Doantheodoisuckhoe/Thietbitheodoisuckhoe/docs/giao-thuc-ble.md

# Giao thức BLE giữa đồng hồ và app

Tài liệu cho người làm app (SV2). Firmware tương ứng: `firmware/ble_suc_khoe/ble_suc_khoe.ino`.

## Cách hệ thống gửi cảnh báo (phương án 1, chốt 21/10/2026)

```
Đồng hồ (XIAO nRF52840) --BLE--> App Android trên điện thoại người già --SMS / gọi--> Người thân
                                          \--(sau M2) Firebase --> Web cho người thân xem
```

Đồng hồ chỉ có Bluetooth, không có SIM. App là thứ gửi SMS, nên:
- App phải chạy nền liên tục (Android: *foreground service* có thông báo cố định) và tự kết nối lại khi mất kết nối.
- Điện thoại phải ở trong khoảng ~10 m. Ngoài tầm thì cảnh báo nằm chờ trên đồng hồ, kết nối lại là được gửi
  (đồng hồ gửi lại mỗi 5 giây đến khi app xác nhận). Ghi giới hạn này vào báo cáo.

## Tìm và kết nối

- Tên quảng bá: `DoAn-SucKhoe`.
- Gói quảng bá chứa UUID service riêng `4b3a0001-8f6e-4c2a-9d1b-3e5f7a9c0b1d`: lọc khi quét theo UUID này.
- Không cần ghép đôi (pairing), không có mã PIN.

## Các service và đặc tính

| Service | Đặc tính | UUID | Thuộc tính | Nội dung |
|---|---|---|---|---|
| Riêng `4b3a0001-…` | **Số đo** | `4b3a0002-8f6e-4c2a-9d1b-3e5f7a9c0b1d` | Read, Notify | 10 byte, mỗi giây 1 lần |
| | **Cảnh báo** | `4b3a0003-8f6e-4c2a-9d1b-3e5f7a9c0b1d` | Read, Notify | 4 byte, khi có cảnh báo (gửi lại mỗi 5 giây đến khi xác nhận) |
| | **Lệnh** | `4b3a0004-8f6e-4c2a-9d1b-3e5f7a9c0b1d` | Write, Write without response | 1–5 byte, app gửi xuống |
| | **ECG** | `4b3a0005-8f6e-4c2a-9d1b-3e5f7a9c0b1d` | Notify | gói sóng điện tim khi đang đo 30 giây (từ 28/10/2026) |
| Heart Rate chuẩn `0x180D` | Heart Rate Measurement `0x2A37` | | Notify | nhịp tim, để thử bằng nRF Connect |
| Battery chuẩn `0x180F` | Battery Level `0x2A19` | | Read, Notify | % pin |
| Device Information `0x180A` | | | Read | tên hãng, model |

Mọi số nhiều byte đều **little endian** (byte thấp trước).

### Số đo (10 byte)

| Byte | Kiểu | Tên | Ý nghĩa |
|---|---|---|---|
| 0 | uint8 | phiên bản | luôn `1`; đổi định dạng thì tăng số này |
| 1 | uint8 | cờ | bit0 = đang đeo (cảm biến chạm da), bit1 = nhiệt độ hợp lệ, bit2 = SpO2 hợp lệ, bit3 = IMU hoạt động, bit4 = pin yếu (< 3,5 V, từ 12/11/2026) |
| 2 | uint8 | nhịp tim | lần/phút, `0` = chưa có |
| 3 | uint8 | SpO2 | %, `0` = chưa có |
| 4–5 | int16 | nhiệt độ | đơn vị 0,01 °C (`3650` = 36,50 °C) |
| 6–7 | uint16 | pin | mV |
| 8 | uint8 | pin | % (ước lượng 3,3 V = 0 %, 4,2 V = 100 %) |
| 9 | uint8 | cảnh báo đang chờ | số thứ tự cảnh báo chưa được app xác nhận, `0` = không có |

Ví dụ: `01 07 48 61 42 0E 68 10 50 00` → đang đeo, nhiệt độ + SpO2 hợp lệ, nhịp 72, SpO2 97 %,
nhiệt độ 0x0E42 = 3650 → 36,50 °C, pin 0x1068 = 4200 mV, 80 %, không có cảnh báo chờ.

**Lưu ý:** SpO2 đang dùng công thức chung, chưa hiệu chuẩn; nhiệt độ là nhiệt độ da cổ tay (thấp hơn thân nhiệt).
Cả hai sẽ được chỉnh khi đo đối chứng với máy kẹp ngón và nhiệt kế.

### Cảnh báo (4 byte)

| Byte | Kiểu | Tên | Ý nghĩa |
|---|---|---|---|
| 0 | uint8 | mã | xem bảng dưới; `0` = không có cảnh báo |
| 1 | uint8 | số thứ tự | 1–255, tăng mỗi cảnh báo mới. App dùng để không gửi SMS 2 lần cho cùng một cảnh báo |
| 2–3 | uint16 | giá trị | nhịp tim, SpO2 hoặc nhiệt độ (0,01 °C) lúc báo; `0` với SOS và té ngã |

| Mã | Tên | Khi nào đồng hồ báo | Mức |
|---|---|---|---|
| 1 | SOS | Giữ nút SOS 1 giây | Khẩn cấp |
| 2 | Té ngã | IMU phát hiện té ngã, rung 15 giây mà người đeo không bấm nút hủy | Khẩn cấp |
| 3 | Nhịp tim cao | > 120 lần/phút liên tục 15 giây | Chỉ số |
| 4 | Nhịp tim thấp | < 40 lần/phút liên tục 15 giây | Chỉ số |
| 5 | SpO2 thấp | < 90 % liên tục 15 giây | Chỉ số |
| 6 | Sốt | ≥ 38,0 °C liên tục 15 giây | Chỉ số |

Cảnh báo chỉ số cùng loại không báo lại trong 5 phút. Đồng hồ giữ **một** cảnh báo chờ tại một thời điểm;
SOS/té ngã được ghi đè lên cảnh báo chỉ số đang chờ, ngược lại thì không.

### Lệnh (app ghi xuống)

| Byte | Ý nghĩa |
|---|---|
| `01 nn` | Xác nhận đã xử lý cảnh báo số thứ tự `nn` (đã gửi SMS). Đồng hồ ngừng gửi lại và rung dài 1 giây để người đeo biết "đã báo người thân" |
| `02` | Tìm đồng hồ: rung 2 giây |
| `03` | Bắt đầu đo ECG 30 giây (chỉ chạy khi app đã bật notify ở đặc tính ECG) |
| `04` | Dừng đo ECG giữa chừng |
| `05 t0 t1 t2 t3` | Đặt giờ: số giây từ 01/01/2000 00:00 **theo giờ địa phương** (uint32 little-endian). App gửi mỗi lần kết nối. Đồng hồ không có pin RTC riêng: mất nguồn thì hiện `--:--` cho tới lần kết nối sau |

| `06 ss` | Thời gian màn hình sáng khi bấm nhanh nút: `ss` giây (3–120, ngoài khoảng thì đồng hồ ép về 3 hoặc 120). Mặc định 10. App gửi mỗi lần kết nối và khi đổi trong app (từ 12/11/2026) |
| `07 AA` | Tắt hẳn đồng hồ (System OFF). Byte `AA` để tránh tắt nhầm. Bật lại: giữ nút 2 giây hoặc cắm sạc (từ 12/11/2026) |

Ví dụ đặt giờ 30/10/2026 12:34:56: 846 678 896 giây = 0x32774B70 → ghi `05 70 4B 77 32`.

### Tiết kiệm pin và tắt hẳn (từ 12/11/2026)

Đồng hồ **không tắt khi không dùng**, vì lúc người đeo không đụng vào đồng hồ vẫn cần canh té ngã và nhịp tim.
Thay vào đó:

- Màn hình tắt khi không dùng; bấm nhanh nút thì sáng trong thời gian cài bằng lệnh `06`.
  Té ngã, cảnh báo đang chờ, "đã báo người thân" thì màn tự sáng.
- CPU ngủ giữa các lần đọc cảm biến (mỗi 10 ms), trừ lúc đang đo ECG.
- Pin < 3,5 V (2 lần đọc liên tiếp, cách nhau 30 giây): rung 3 lần, bật bit4 "pin yếu" trong gói Số đo.
- Pin < 3,4 V (2 lần liên tiếp), không cắm USB: rung 2 lần dài rồi **tắt hẳn** để không xả cạn pin.
  Không tắt khi đang đếm hủy té ngã, đang đo ECG, hoặc có cảnh báo chờ mà điện thoại đang kết nối.
- Đang tắt hẳn: giữ nút 2 giây thì bật (rung ngắn 1 lần). Bấm nhanh thì ngủ lại. Cắm sạc cũng làm đồng hồ bật.

Giới hạn: mạch không có khóa nguồn, nên khi "tắt hẳn" AD8232 (~0,2 mA) vẫn ăn pin; màn GC9A01 **7 chân**
không có chân BLK nên đèn nền sáng suốt (10–20 mA) kể cả khi tắt. Dùng màn 8 chân, nối BLK → D3.

### ECG (gói sóng điện tim)

Khi nhận lệnh `03`, đồng hồ đọc OUTPUT của AD8232 (chân A0, ADC 12 bit) **250 mẫu/giây trong 30 giây**
(7500 mẫu) bằng ngắt TIMER4, rồi gửi dần qua notify. Chân D1 (LO+/LO- gộp) = 1 nghĩa là tuột điện cực.

| Byte | Kiểu | Tên | Ý nghĩa |
|---|---|---|---|
| 0–1 | uint16 | số gói | 0, 1, 2… trong một lần đo. App thấy nhảy số thì biết mất gói |
| 2 | uint8 | cờ | bit0 = có mẫu bị tuột điện cực trong gói, bit1 = gói cuối của lần đo |
| 3 | uint8 | n | số mẫu trong gói |
| 4… | n × uint16 | mẫu | giá trị ADC 0–4095 |

- App xin MTU 247 ngay khi kết nối. MTU ≥ 57 thì mỗi gói 25 mẫu (54 byte, 10 gói/giây); nếu không xin được thì
  8 mẫu/gói (20 byte, vừa MTU mặc định 23).
- Gói cuối có cờ bit1; có thể là gói rỗng (`n = 0`).
- Đồng hồ có bộ đệm 512 mẫu (~2 giây). Bluetooth gửi không kịp thì mẫu mới bị bỏ, lần đo vẫn dài đúng 30 giây,
  app thấy thiếu mẫu. Mất kết nối hoặc quá 45 giây chưa gửi xong thì đồng hồ tự dừng.
- Trong lúc đo đồng hồ vẫn gửi Số đo mỗi giây và cảnh báo như bình thường (bỏ qua đọc pin).

Ví dụ: `0C 00 01 02 D0 07 DA 07` → gói số 12, có tuột điện cực, 2 mẫu: 0x07D0 = 2000, 0x07DA = 2010.

App tính nhịp tim từ sóng (`app/suc_khoe/lib/ecg.dart`, bản Python `algorithm/ecg/phan_tich_ecg.py`):
lọc trung bình 5 mẫu (bỏ nhiễu 50 Hz), trừ trung bình 0,6 giây (bỏ trôi nền), rồi Pan-Tompkins rút gọn
(đạo hàm, bình phương, tích phân 150 ms, ngưỡng 0,3 × phân vị 98 %) để tìm đỉnh R; nhịp = 60 / trung vị R-R.

## Việc app cần làm khi nhận cảnh báo

1. Nếu `số thứ tự` trùng cảnh báo vừa xử lý → bỏ qua (đây là gói gửi lại).
2. Lấy vị trí GPS hiện tại của điện thoại.
3. Gửi SMS cho từng số người thân đã lưu trong app (Android `SmsManager`), ví dụ:
   `[DoAn-SucKhoe] CANH BAO TE NGA luc 14:32 21/10. Vi tri: https://maps.google.com/?q=21.0285,105.8542`
   Viết không dấu để 1 tin SMS chứa được 160 ký tự (có dấu chỉ còn 70).
4. Với SOS/té ngã: gọi điện cho người thân đầu tiên (tùy chọn).
5. Ghi `01 nn` vào đặc tính Lệnh.
6. (Sau M2) đẩy cảnh báo và số đo lên Firebase.

Quyền Android cần: `BLUETOOTH_SCAN`, `BLUETOOTH_CONNECT`, `SEND_SMS`, `CALL_PHONE`, `ACCESS_FINE_LOCATION`,
`FOREGROUND_SERVICE`, `POST_NOTIFICATIONS`. App có quyền gửi SMS không đưa được lên Google Play nếu không phải
app SMS mặc định, nhưng cài file APK trực tiếp để demo thì không sao.

## Thử khi chưa có app

- **Điện thoại:** app nRF Connect → SCAN → CONNECT `DoAn-SucKhoe` → mở service `4b3a0001-…` → bấm biểu tượng
  3 mũi tên ở Số đo và Cảnh báo để bật notify. Giữ nút SOS (hoặc chạm dây D9 vào GND) 1 giây để thấy cảnh báo.
  Ghi `0101` (kiểu byte array) vào Lệnh để xác nhận cảnh báo số 1.
  Thử ECG: bật notify ở đặc tính ECG rồi ghi `03` vào Lệnh, sẽ thấy gói ECG chạy liên tục trong 30 giây.
- **Máy tính có Bluetooth:** `pip install bleak`, rồi `python app/thu_ble_tren_may_tinh.py`. Script in số đo,
  in cảnh báo và tự gửi xác nhận, giống việc app sẽ làm (chỉ thiếu bước gửi SMS).
