Doantheodoisuckhoe/Thietbitheodoisuckhoe/docs/nhat-ky.md

# Nhật ký thực hiện

Ghi lại việc đã làm và quyết định quan trọng theo ngày — dùng lại khi viết báo cáo và trả lời hội đồng.
Mục mới nhất ở trên cùng.

## 05/10/2026 – Tuần 1: thiết lập dự án

**Đã làm**
- Tạo repo GitHub, clone về `C:\DoAnTotNghiep` (máy SV1); thêm `.gitattributes` chuẩn hóa xuống dòng.
- Tạo thư mục Drive chung với 6 mục: 01 Tài liệu tham khảo · 02 Dữ liệu đo · 03 Báo cáo và slide ·
  04 Hình ảnh, video · 05 Mạch và vỏ (bản phát hành) · 06 Hành chính.
- Bảng Trello theo dõi việc; báo cáo tiến độ tự động đăng tối Chủ Nhật trước giờ họp nhóm 20:30.
- Cài Arduino IDE 2.3.10, gói Seeed nRF52 Boards 1.1.13 và 6 thư viện cảm biến; sketch
  `firmware/kiem_tra_thu_vien` biên dịch được cho XIAO nRF52840 Sense.
- Chốt danh sách mua đợt 1 (~2,03 triệu): xem `docs/mua-sam/`.

**Quyết định**
- Dùng gói board *Seeed nRF52 Boards* (không dùng bản mbed): có Bluefruit cho BLE, tiết kiệm pin tốt hơn.
- Máy đo đối chứng: máy SpO2 Jumper JPD-500E, nhiệt kế Omron MC-246, dùng máy huyết áp bắp tay nhóm đã có.
- Vẽ vỏ bằng **Onshape** (gói Education, miễn phí với email sinh viên): chạy trên trình duyệt, không cài,
  cả nhóm cùng mở, xuất STL để in 3D.

**Trạng thái**
- Đề cương: đã nộp, chờ GVHD duyệt.
- Chưa biết ngày nộp báo cáo, ngày bảo vệ và quy định trình bày — cần hỏi GVHD trước 11/10.
- Chưa có linh kiện.
