Doantheodoisuckhoe/Thietbitheodoisuckhoe/firmware/ble_suc_khoe/xem_truoc/anh/1_man_chinh.png

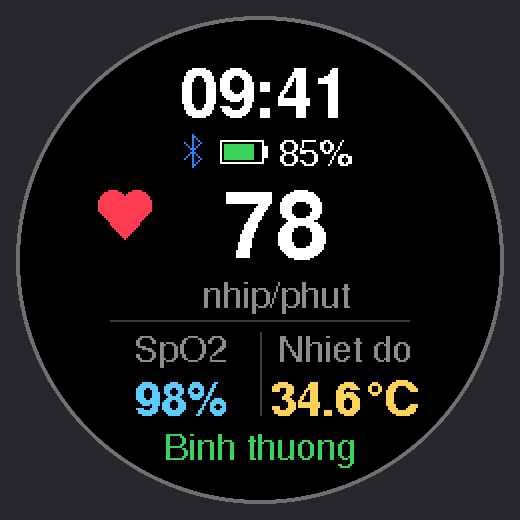
firmware/ble_suc_khoe/xem_truoc/anh/1_man_chinh.png
