Doantheodoisuckhoe/Thietbitheodoisuckhoe/firmware/ble_suc_khoe/xem_truoc/anh/2_man_chinh_mat_ket_noi.png

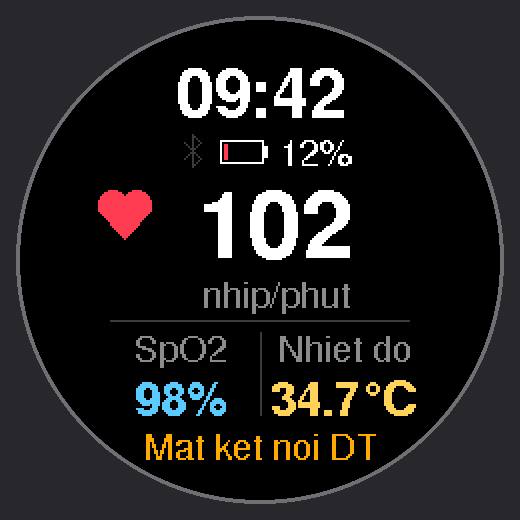
firmware/ble_suc_khoe/xem_truoc/anh/2_man_chinh_mat_ket_noi.png
