Doantheodoisuckhoe/Thietbitheodoisuckhoe/firmware/ble_suc_khoe/xem_truoc/anh/3_chua_deo.png

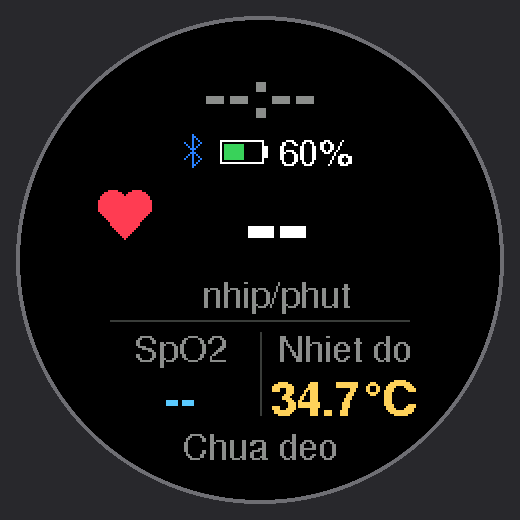
firmware/ble_suc_khoe/xem_truoc/anh/3_chua_deo.png
