Doantheodoisuckhoe/Thietbitheodoisuckhoe/firmware/ble_suc_khoe/xem_truoc/anh/4_te_nga_dem_nguoc.png

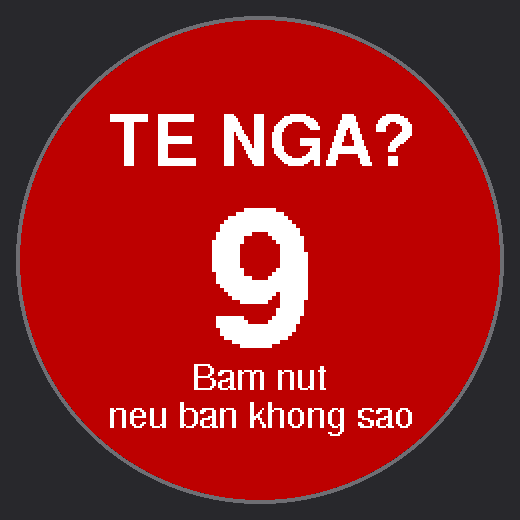
firmware/ble_suc_khoe/xem_truoc/anh/4_te_nga_dem_nguoc.png
