Doantheodoisuckhoe/Thietbitheodoisuckhoe/firmware/ble_suc_khoe/xem_truoc/anh/5_sos.png

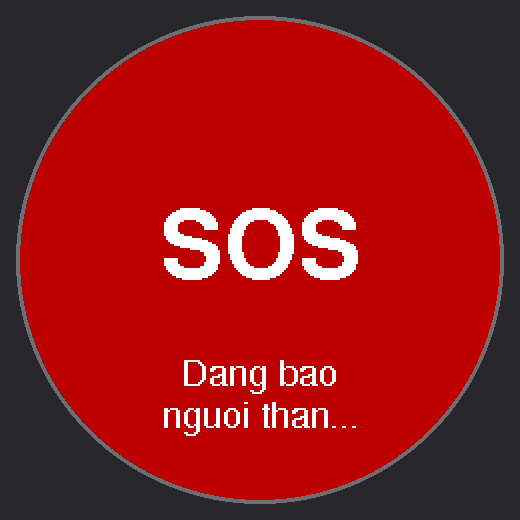
firmware/ble_suc_khoe/xem_truoc/anh/5_sos.png
