Doantheodoisuckhoe/Thietbitheodoisuckhoe/firmware/ble_suc_khoe/xem_truoc/anh/6_nhip_tim_cao.png

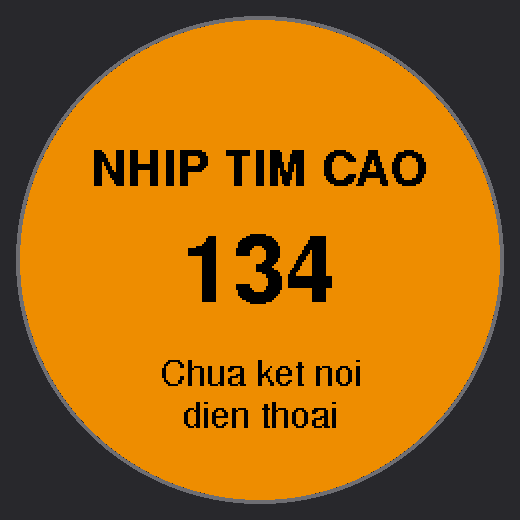
firmware/ble_suc_khoe/xem_truoc/anh/6_nhip_tim_cao.png
