Doantheodoisuckhoe/Thietbitheodoisuckhoe/firmware/ble_suc_khoe/xem_truoc/anh/7_sot.png

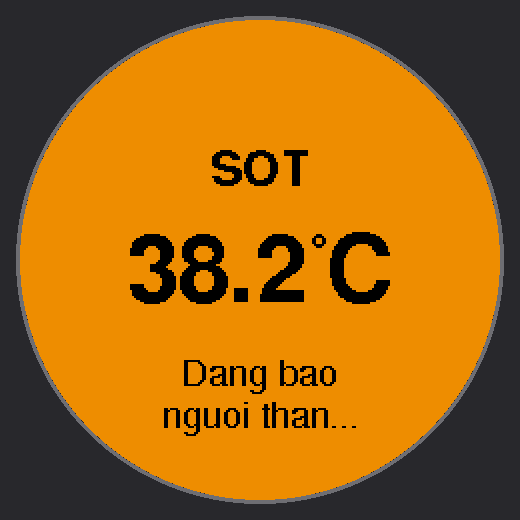
firmware/ble_suc_khoe/xem_truoc/anh/7_sot.png
