Doantheodoisuckhoe/Thietbitheodoisuckhoe/firmware/ble_suc_khoe/xem_truoc/anh/8_da_bao.png

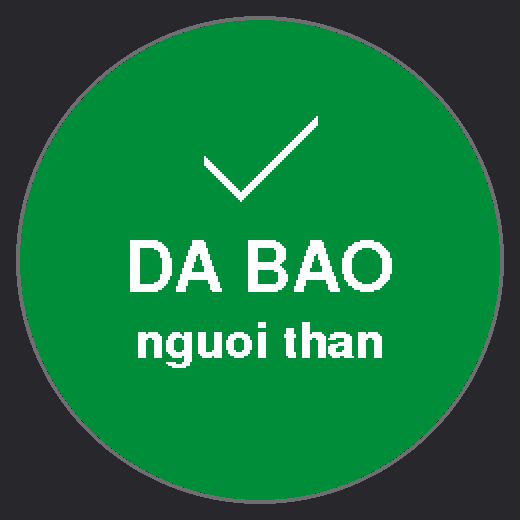
firmware/ble_suc_khoe/xem_truoc/anh/8_da_bao.png
