Doantheodoisuckhoe/Thietbitheodoisuckhoe/firmware/ble_suc_khoe/xem_truoc/anh/tong_hop_man_hinh.png

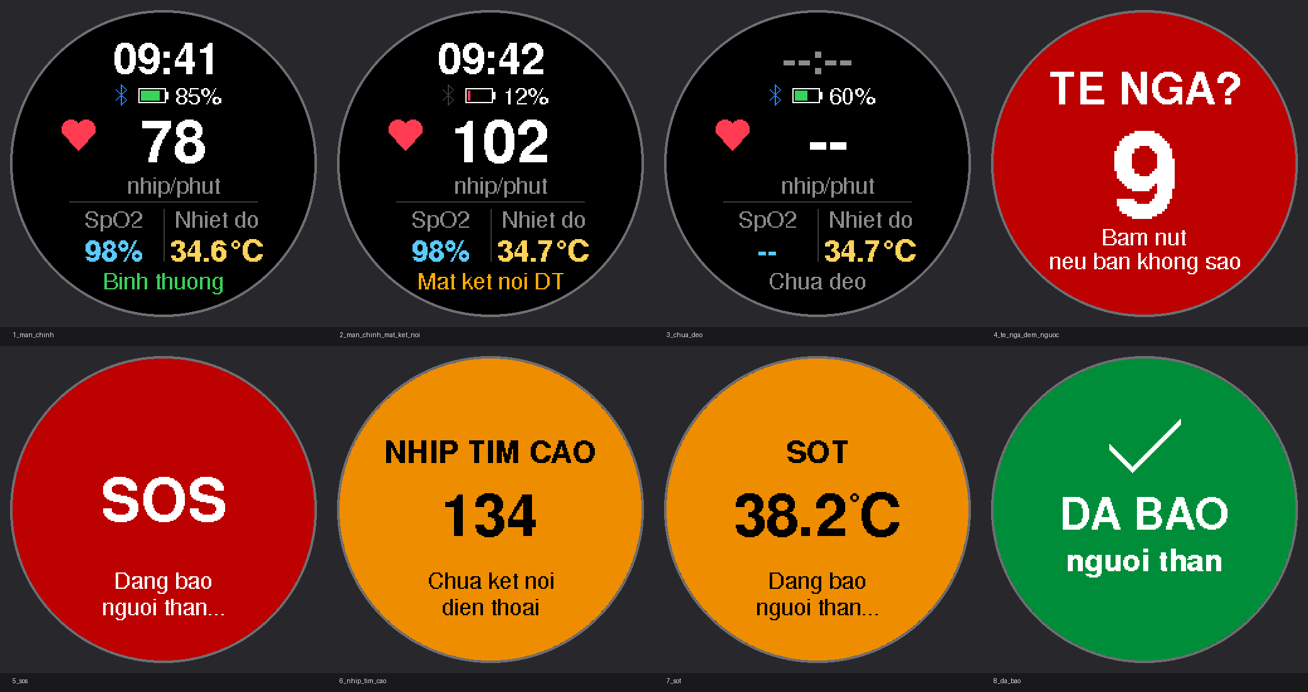
firmware/ble_suc_khoe/xem_truoc/anh/tong_hop_man_hinh.png
