Doantheodoisuckhoe/Thietbitheodoisuckhoe/hardware/pcb_module_v2/xuat/pcb_chong_tang_module.png

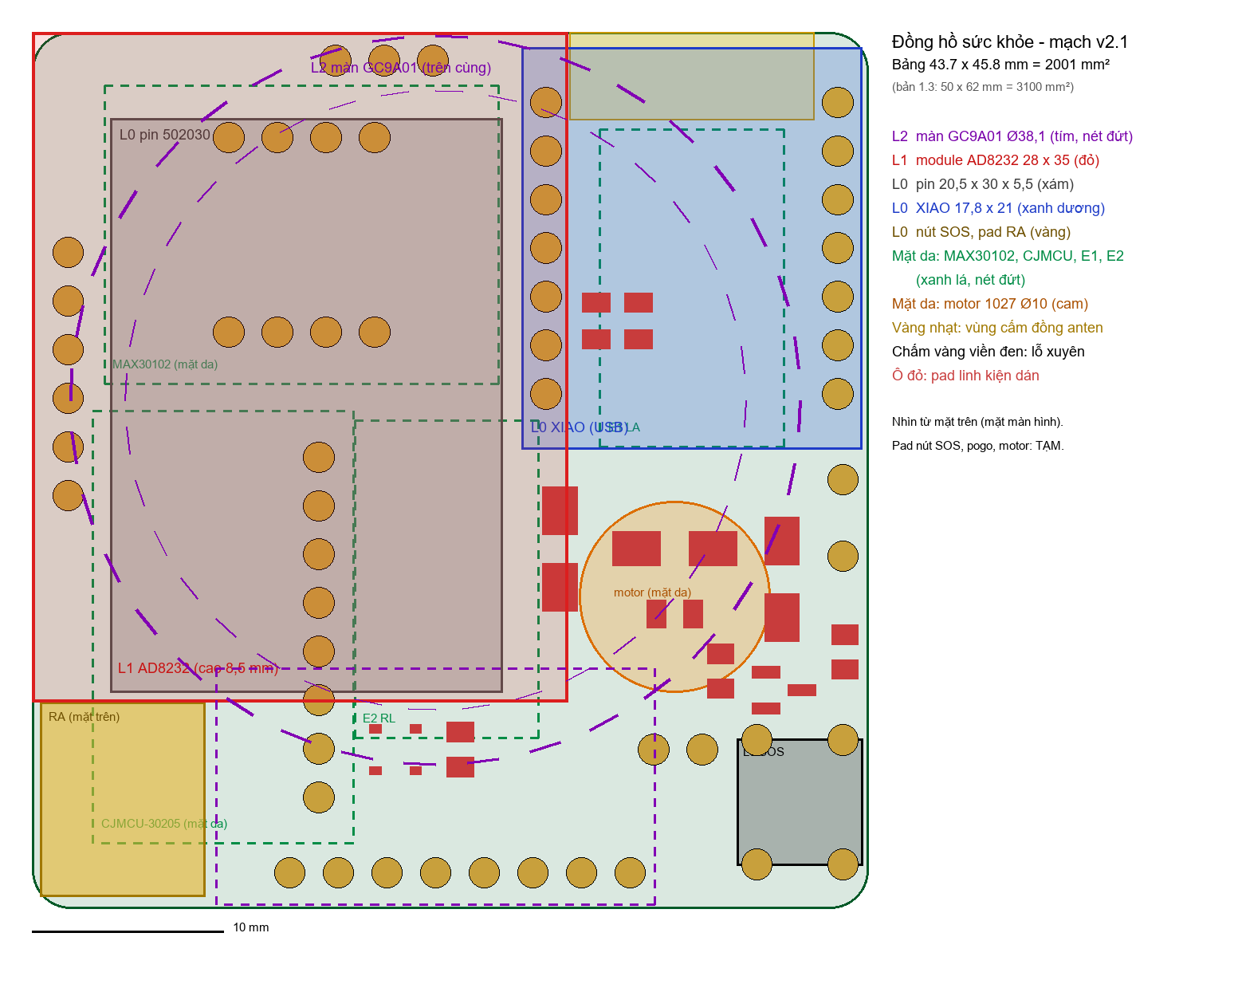
hardware/pcb_module_v2/xuat/pcb_chong_tang_module.png
