Doantheodoisuckhoe/Thietbitheodoisuckhoe/hardware/pcb_module_v2/xuat/pcb_mat_tren.png

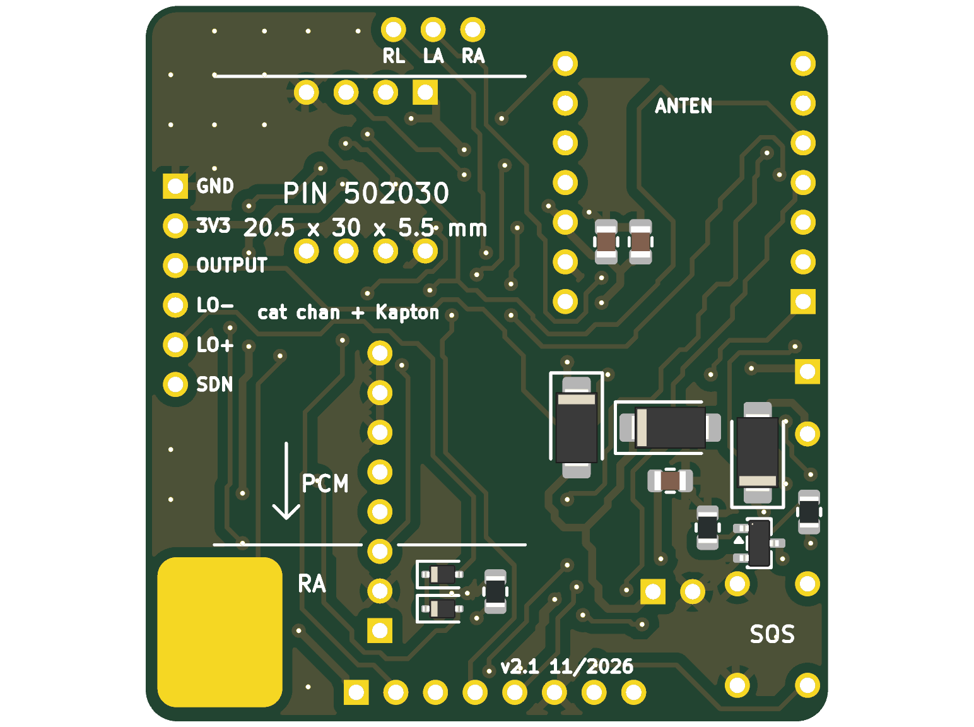
hardware/pcb_module_v2/xuat/pcb_mat_tren.png
