Doantheodoisuckhoe/Thietbitheodoisuckhoe/hardware/pcb_module_v2/xuat/bom.csv

Reference | Value | Footprint | QUANTITY | Description
C1,C3 | 10uF | Capacitor_SMD:C_0805_2012Metric | 2 | Tụ gốm 0805 X5R/X7R, 10 V trở lên
C2 | 100nF | Capacitor_SMD:C_0805_2012Metric | 1 | Tụ gốm 0805 X5R/X7R, 10 V trở lên
D1,D5 | SS14 | Diode_SMD:D_SMA | 2 | Diode Schottky 40 V 1 A, SMA (D5: chặn dòng ngược về pogo; D1: dập xung ngược motor)
D2,D3 | 1N4148WS | Diode_SMD:D_SOD-323 | 2 | Diode tín hiệu 75 V 150 mA, SOD-323 (cổng OR LO+ / LO-)
D4 | SMAJ5.0A | Diode_SMD:D_SMA | 1 | TVS một chiều 5 V, 400 W, SMA (bảo vệ chân sạc)
J2 | Pogo sạc (nam châm) | DoAnModule:Pogo_2pad_P2.54_TAM | 1 | Chân sạc pogo nam châm 2 chân hàn thẳng mặt dưới (TẠM, bước 2,54): 1 = +5V, 2 = GND
M1 | Motor rung 1027 | DoAnModule:Motor_1027_2pad_P4.0_TAM | 1 | Motor rung đồng xu 1027 (10 mm, 3 V), 2 dây hàn thẳng vào pad (TẠM bước 4,0 mm): 1 = +3V3, 2 = MOTOR_N
Q1 | AO3400A | Package_TO_SOT_SMD:SOT-23 | 1 | MOSFET kênh N 30 V 5,7 A, SOT-23 (đóng cắt motor)
R1 | 100R | Resistor_SMD:R_0805_2012Metric | 1 | Điện trở 0805, 1%
R2,R3 | 100k | Resistor_SMD:R_0805_2012Metric | 2 | Điện trở 0805, 1%
SW1 | SOS 6x6x7.5 góc vuông | DoAnModule:SW_SOS_6x6_GocVuong_TAM | 1 | Nút nhấn 6x6x7,5 mm góc vuông hàn mép mạch (TẠM footprint 6,5 x 4,5 mm): 1 = D9, 2 = GND
U1 | XIAO nRF52840 Sense | DoAnModule:XIAO_nRF52840_DeCam_2x7_P2.54_15.24mm | 1 | Seeed XIAO nRF52840 Sense hàn thẳng lên mạch bằng 2 hàng chân 1x7 (2,54 mm, hai hàng cách 15,24 mm)
U2 | MAX30102 (module 2x4) | DoAnModule:Module_MAX30102_2x4 | 1 | Module MAX30102 đen 2x4 chân (HW-605, I2C 0x57): 1 VIN, 2 SDA, 3 SCL, 4 GND, 5 GND, 6 RD, 7 IRD, 8 INT
U3 | CJMCU-30205 | DoAnModule:Module_CJMCU-30205_1x8 | 1 | Module CJMCU-30205 (MAX30205, I2C 0x48 khi A0=A1=A2=GND), header 1x8: VCC GND SDA SCL OS A0 A1 A2. VCC chỉ 3,3 V
U4 | AD8232 (module) | DoAnModule:Module_AD8232_9chan | 1 | Module AD8232 (ECG) cắm thẳng vào mạch qua 9 lỗ: 1 RA, 2 LA, 3 RL, 4 GND, 5 3V3, 6 OUTPUT, 7 LO-, 8 LO+, 9 SDN
U5 | GC9A01 1.28in | DoAnModule:Display_GC9A01_8chan | 1 | Màn tròn 1,28" GC9A01 (SPI) hàn thẳng vào mạch: 1 RST, 2 CS, 3 DC, 4 SDA, 5 SCL, 6 GND, 7 VCC, 8 BLK (pad 8 chỉ dùng với module 8 chân)
