Doantheodoisuckhoe/Thietbitheodoisuckhoe/hardware/pcb/xuat/bom_jlcpcb.csv

Comment | Designator | Footprint | LCSC
1uF 50V | C1,C2 | C_0603_1608Metric | C15849
10uF 10V | C3 | C_0603_1608Metric | C19702
100nF | C4,C6,C7,C15,C16 | C_0603_1608Metric | C14663
4.7uF 16V | C5 | C_0603_1608Metric | C19666
1nF | C10 | C_0603_1608Metric | C1588
330nF | C11,C12 | C_0603_1608Metric | C1615
10nF | C13 | C_0603_1608Metric | C57112
1.5nF | C14 | C_0603_1608Metric | C1595
SMF5.0A | D1 | D_SMF | C151296
B5819W | D2 | D_SOD-123 | C8598
ESD9B5.0ST5G | D3-D5 | D_SOD-923 | C111566
AO3400A | Q1 | SOT-23 | C20917
4.7k | R1-R3 | R_0603_1608Metric | C23162
10k | R4,R5,R24 | R_0603_1608Metric | C25804
0R | R6,R14,R23 | R_0603_1608Metric | C21189
100R | R7 | R_0603_1608Metric | C22775
100k | R8,R22 | R_0603_1608Metric | C25803
180k | R10,R11 | R_0603_1608Metric | C22827
10M | R12,R13,R16,R17,R25,R26 | R_0603_1608Metric | C7250
360k | R15 | R_0603_1608Metric | C23146
1.4M | R18 | R_0603_1608Metric | C38070
1M | R19-R21 | R_0603_1608Metric | C22935
ME6211C18M5G-N | U2 | SOT-23-5 | C236671
MAX30101EFD+T | U3 | Maxim_OLGA-14_3.3x5.6mm_P0.8mm | C2859066
TMP117MAIDRVR | U4 | WSON-6-1EP_2x2mm_P0.65mm_EP1x1.6mm | C2803242
AD8232ACPZ-R7 | U5 | LFCSP-20-1EP_4x4mm_P0.5mm_EP2.1x2.1mm | C43216
