Doantheodoisuckhoe/Thietbitheodoisuckhoe/hardware/pcb/xuat/so_do_nguyen_ly.pdf

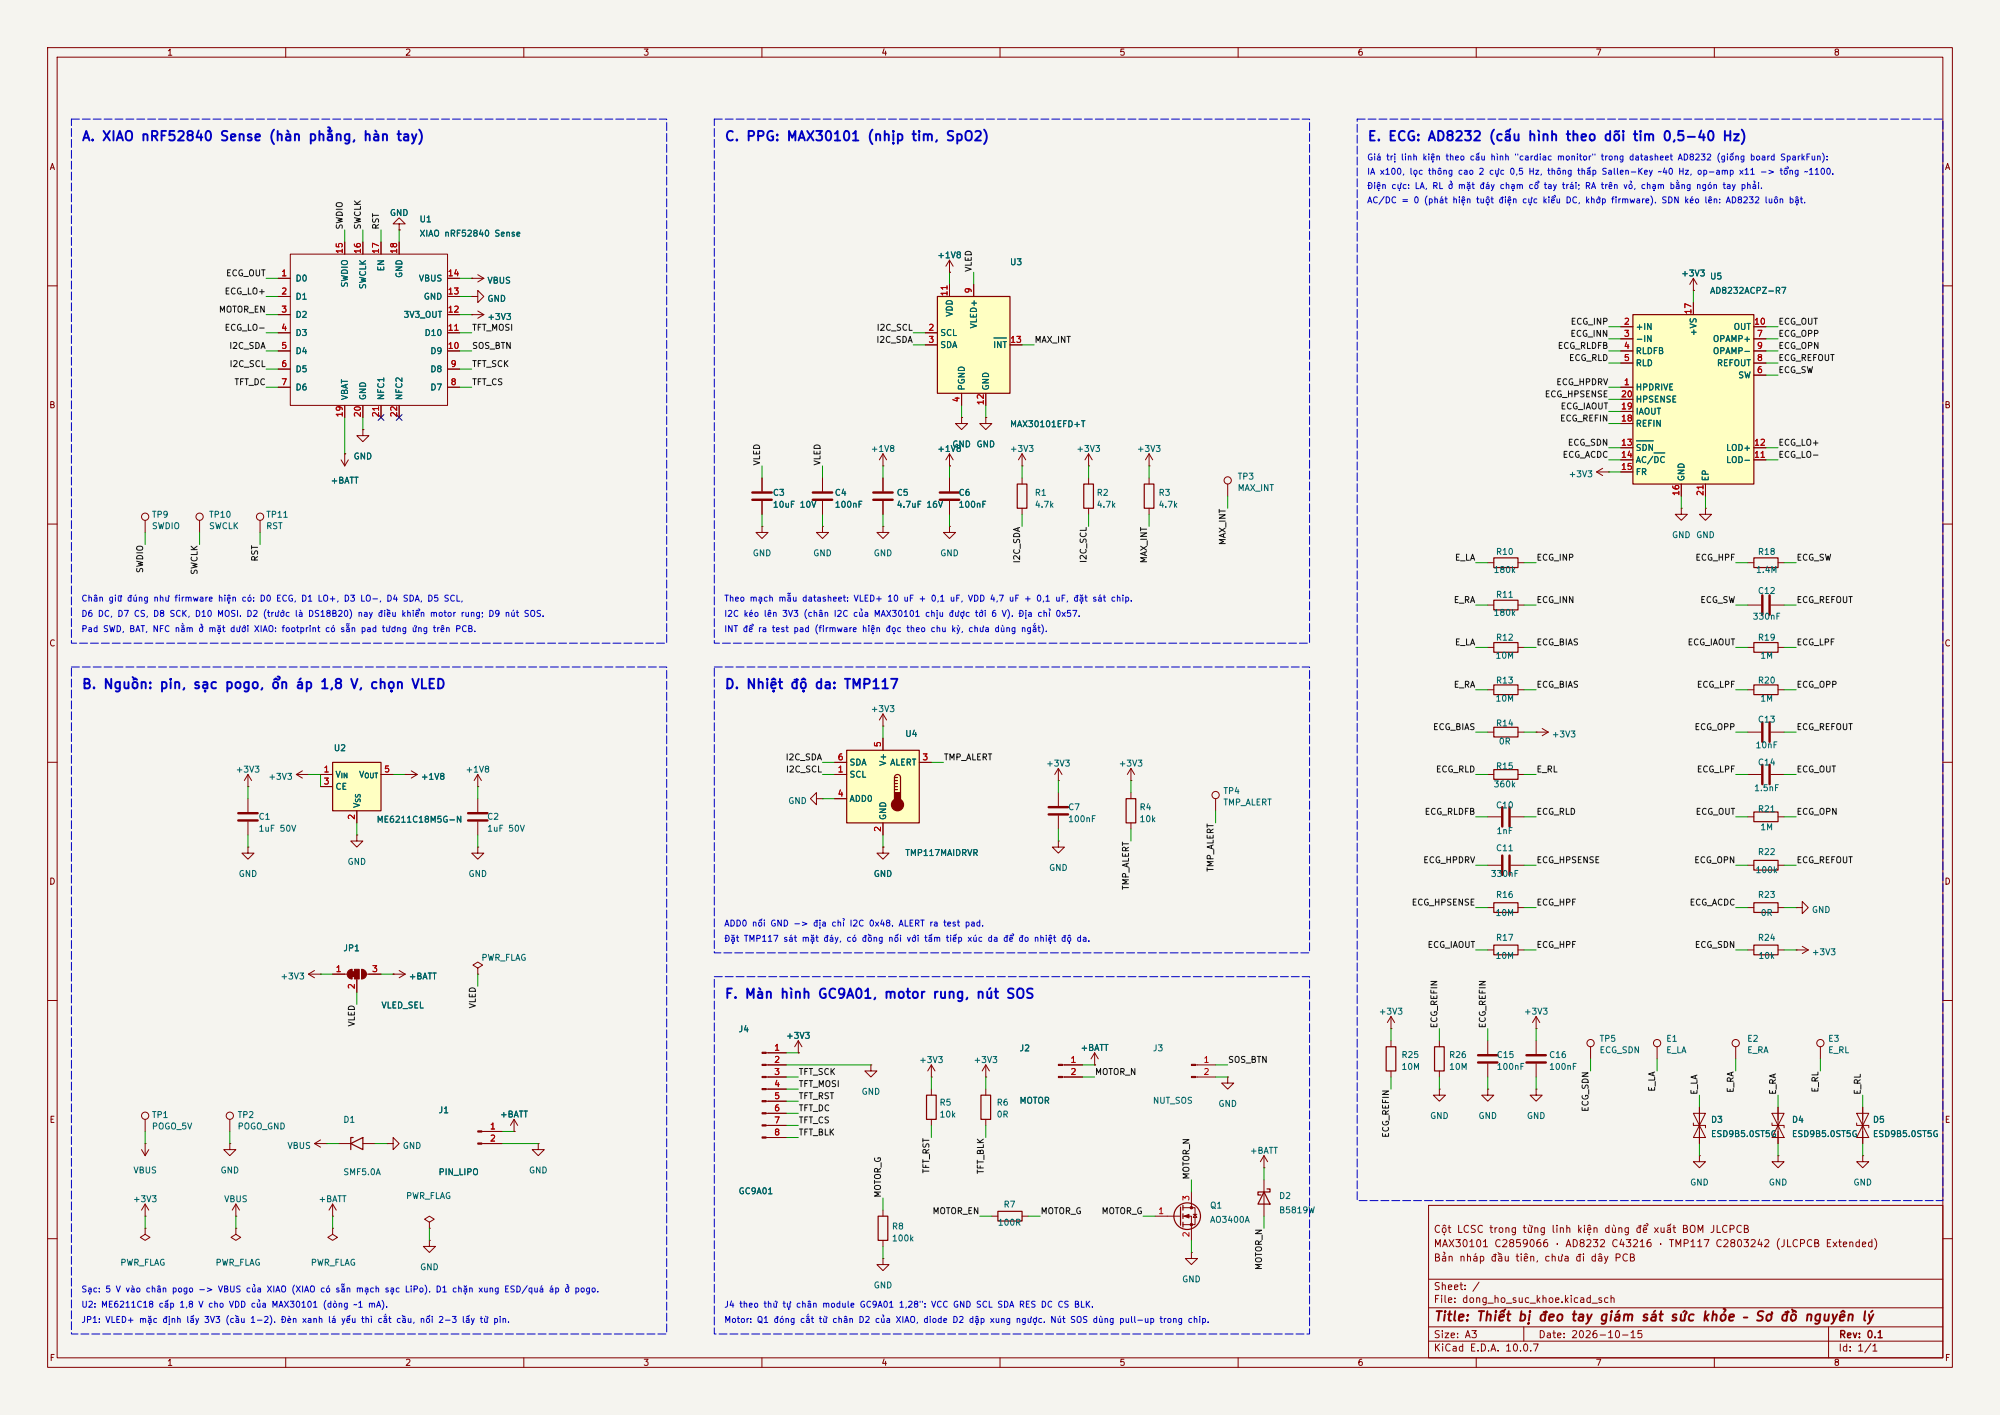
[picture p15: page 1]

IA x100, lọc thông cao 2 cực 0,5 Hz, thông thấp Sallen-Key ~40 Hz, op-amp x11 -> tổng ~1100. A. XIAO nRF52840 Sense (hàn phẳng, hàn tay)

Giá trị linh kiện theo cấu hình "cardiac monitor" trong datasheet AD8232 (giống board SparkFun): Theo mạch mẫu datasheet: VLED+ 10 uF + 0,1 uF, VDD 4,7 uF + 0,1 uF, đặt sát chip.

Điện cực: LA, RL ở mặt đáy chạm cổ tay trái; RA trên vỏ, chạm bằng ngón tay phải.
AD8232ACPZ-R7 R23

AC/DC = 0 (phát hiện tuột điện cực kiểu DC, khớp firmware). SDN kéo lên: AD8232 luôn bật.

I2C kéo lên 3V3 (chân I2C của MAX30101 chịu được tới 6 V). Địa chỉ 0x57. ADD0 nối GND -> địa chỉ I2C 0x48. ALERT ra test pad.

INT để ra test pad (firmware hiện đọc theo chu kỳ, chưa dùng ngắt).

J4 theo thứ tự chân module GC9A01 1,28": VCC GND SCL SDA RES DC CS BLK. B. Nguồn: pin, sạc pogo, ổn áp 1,8 V, chọn VLED

Cột LCSC trong từng linh kiện dùng để xuất BOM JLCPCB
MAX30101 C2859066 · AD8232 C43216 · TMP117 C2803242 (JLCPCB Extended)
Bản nháp đầu tiên, chưa đi dây PCB

Sạc: 5 V vào chân pogo -> VBUS của XIAO (XIAO có sẵn mạch sạc LiPo). D1 chặn xung ESD/quá áp ở pogo.

Sheet: /
File: dong_ho_suc_khoe.kicad_sch
Title: Thiết bị đeo tay giám sát sức khỏe – Sơ đồ nguyên lý

Size: A3 | Rev: 0.1 | F Date: 2026-10-15
KiCad E.D.A. 10.0.7 | Id: 1/1
