Doantheodoisuckhoe/Thietbitheodoisuckhoe/hardware/pcb_module/xuat/so_do_nguyen_ly.pdf

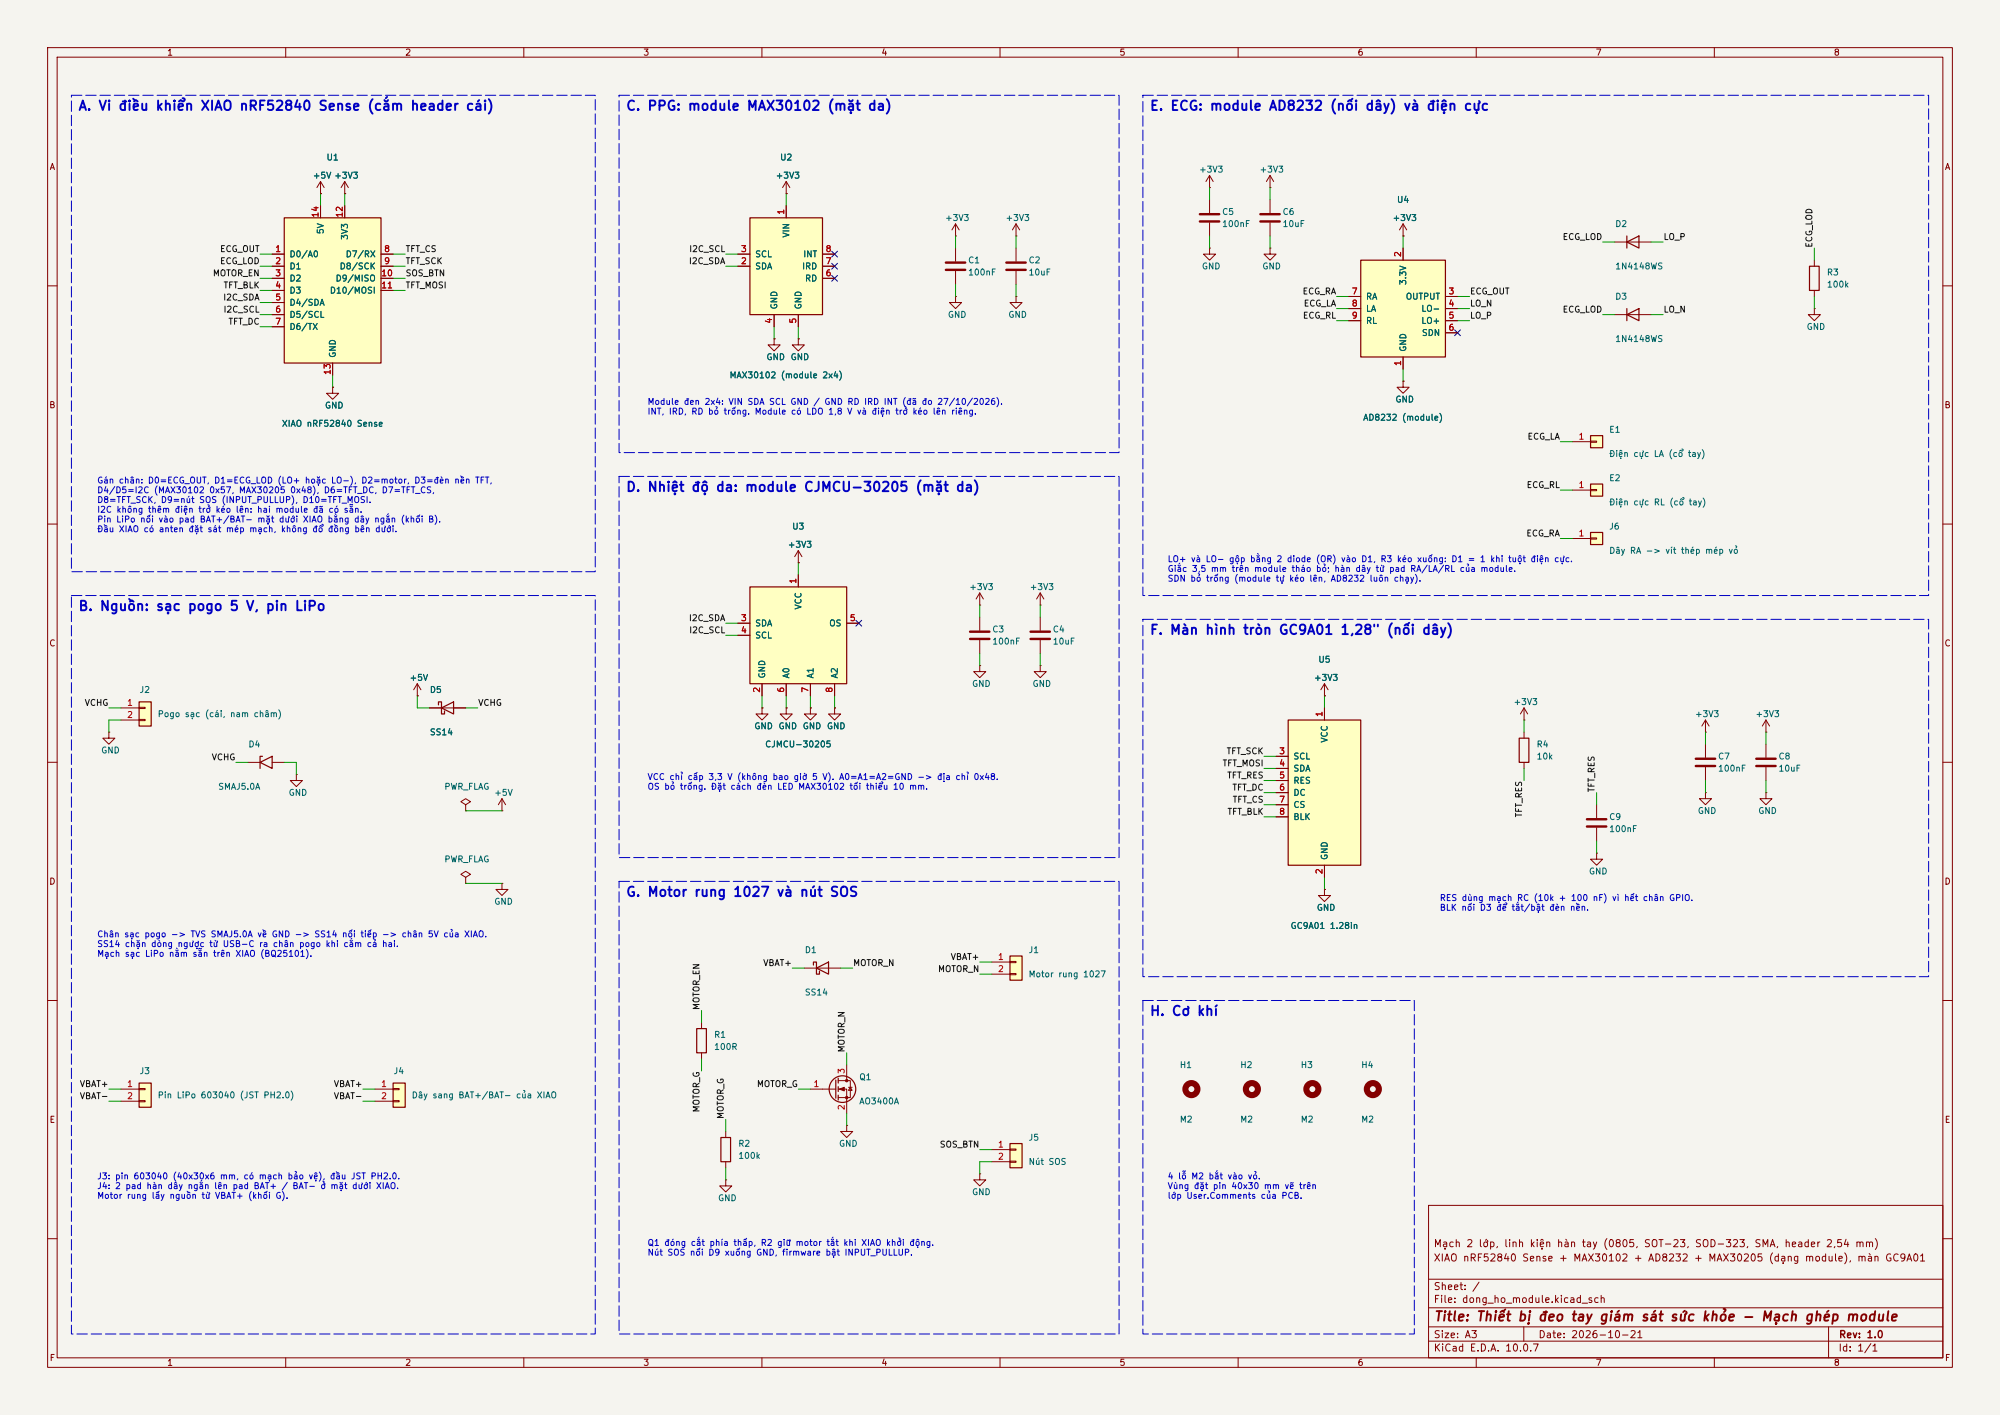
[picture p16: page 1]

J1Motor rung 1027 VIN
I2C_SCL G. Motor rung 1027 và nút SOS

E. ECG: module AD8232 (nối dây) và điện cực

8 GND GND GND GND +3V3 U2 MAX30102 (module 2x4) VIN

J6Dây RA -> vít thép mép vỏ D2

Module đen 2x4: VIN SDA SCL GND / GND RD IRD INT (đã đo 27/10/2026).
INT, IRD, RD bỏ trống. Module có LDO 1,8 V và điện trở kéo lên riêng.

E1Điện cực LA (cổ tay)

Gán chân: D0=ECG_OUT, D1=ECG_LOD (LO+ hoặc LO-), D2=motor, D3=đèn nền TFT,
D4/D5=I2C (MAX30102 0x57, MAX30205 0x48), D6=TFT_DC, D7=TFT_CS,
D8=TFT_SCK, D9=nút SOS (INPUT_PULLUP), D10=TFT_MOSI.
I2C không thêm điện trở kéo lên: hai module đã có sẵn. Pin LiPo nối vào pad BAT+/BAT- mặt dưới XIAO bằng dây ngắn (khối B). Đầu XIAO có anten đặt sát mép mạch, không đổ đồng bên dưới.

D. Nhiệt độ da: module CJMCU-30205 (mặt da)

B. Nguồn: sạc pogo 5 V, pin LiPo

F. Màn hình tròn GC9A01 1,28" (nối dây)
GND +3V3 U5 GC9A01 1.28in VCC

RES dùng mạch RC (10k + 100 nF) vì hết chân GPIO. BLK nối D3 để tắt/bật đèn nền.

H. Cơ khí Chân sạc pogo -> TVS SMAJ5.0A về GND -> SS14 nối tiếp -> chân 5V của XIAO. SS14 chặn dòng ngược từ USB-C ra chân pogo khi cắm cả hai. Mạch sạc LiPo nằm sẵn trên XIAO (BQ25101).

Mạch 2 lớp, linh kiện hàn tay (0805, SOT-23, SOD-323, SMA, header 2,54 mm) 1

J3: pin 603040 (40x30x6 mm, có mạch bảo vệ), đầu JST PH2.0. J4: 2 pad hàn dây ngắn lên pad BAT+ / BAT- ở mặt dưới XIAO. Motor rung lấy nguồn từ VBAT+ (khối G).

4 lỗ M2 bắt vào vỏ.
Vùng đặt pin 40x30 mm vẽ trên
lớp User.Comments của PCB.

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

XIAO nRF52840 Sense + MAX30102 + AD8232 + MAX30205 (dạng module), màn GC9A01

Sheet: /
File: dong_ho_module.kicad_sch
Title: Thiết bị đeo tay giám sát sức khỏe - Mạch ghép module

Size: A3 | Rev: 1.0 | F Date: 2026-10-21
KiCad E.D.A. 10.0.7 | Id: 1/1
