Doantheodoisuckhoe/Thietbitheodoisuckhoe/hardware/pcb_module_v2/dong_ho_module_v2.kicad_pcb

## KiCad design hardware/pcb_module_v2/dong_ho_module_v2.kicad_pcb (2026-11-12)

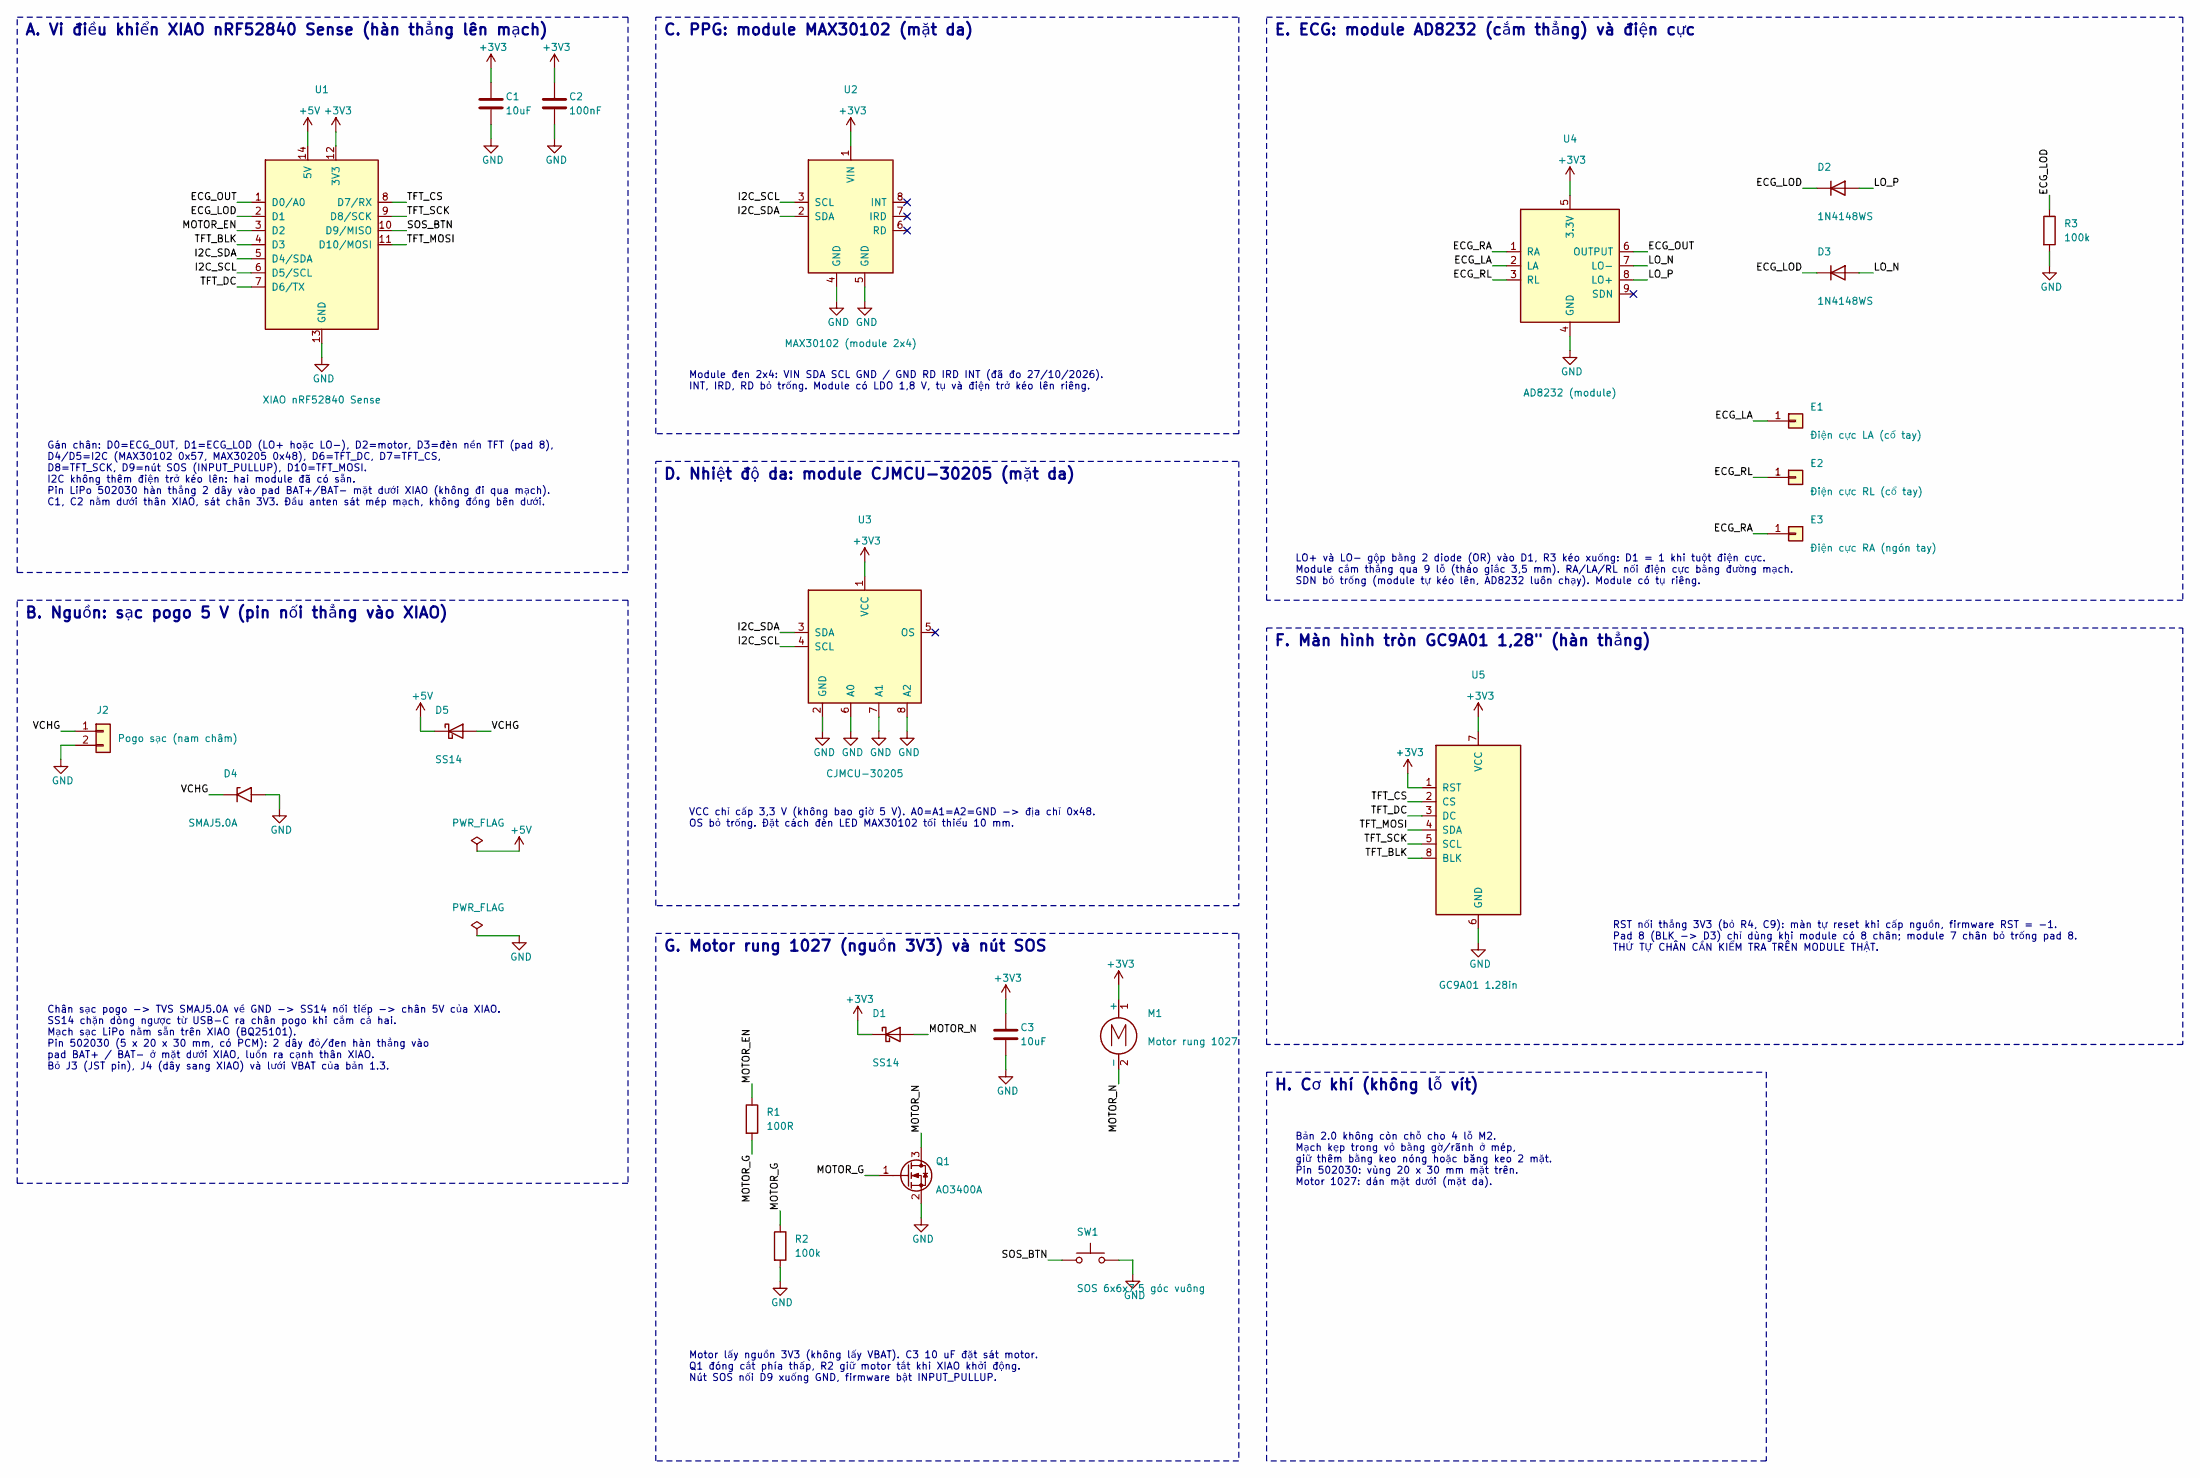
[picture p17: schematic dong_ho_module_v2.kicad_sch, Thiết bị đeo tay giám sát sức khỏe - Mạch ghép module v2.0 …]

Parts:
C1, C3: 10uF; C_0805_2012Metric
C2: 100nF; C_0805_2012Metric
D1, D5: SS14; D_SMA
D2, D3: 1N4148WS; D_SOD-323
D4: SMAJ5.0A; D_SMA
E1: Điện cực LA (cổ tay); DienCuc_ECG_9x16mm
E2: Điện cực RL (cổ tay); DienCuc_ECG_9x16mm
E3: Điện cực RA (ngón tay); DienCuc_RA_8x9.6mm
J2: Pogo sạc (nam châm); Pogo_2pad_P2.54_TAM
M1: Motor rung 1027; Motor_1027_2pad_P4.0_TAM
Q1: AO3400A; SOT-23
R1: 100R; R_0805_2012Metric
R2, R3: 100k; R_0805_2012Metric
SW1: SOS 6x6x7.5 góc vuông; SW_SOS_6x6_GocVuong_TAM
U1: XIAO nRF52840 Sense; XIAO_nRF52840_DeCam_2x7_P2.54_15.24mm
U2: MAX30102 (module 2x4); Module_MAX30102_2x4
U3: CJMCU-30205; Module_CJMCU-30205_1x8
U4: AD8232 (module); Module_AD8232_9chan
U5: GC9A01 1.28in; Display_GC9A01_8chan

Connections:
+3V3: C1.1, C2.1, C3.1, D1.1 (K), M1.1 (+), U1.12 (3V3), U2.1 (VIN), U3.1 (VCC), U4.5 (3.3V), U5.1 (RST), U5.7 (VCC)
+5V: D5.1 (K), U1.14 (5V)
/ECG_LA: E1.1, U4.2 (LA)
/ECG_LOD: D2.1 (K), D3.1 (K), R3.1, U1.2 (D1)
/ECG_OUT: U1.1 (D0/A0), U4.6 (OUTPUT)
/ECG_RA: E3.1, U4.1 (RA)
/ECG_RL: E2.1, U4.3 (RL)
/I2C_SCL: U1.6 (D5/SCL), U2.3 (SCL), U3.4 (SCL)
/I2C_SDA: U1.5 (D4/SDA), U2.2 (SDA), U3.3 (SDA)
/LO_N: D3.2 (A), U4.7 (LO-)
/LO_P: D2.2 (A), U4.8 (LO+)
/MOTOR_EN: R1.1, U1.3 (D2)
/MOTOR_G: Q1.1 (G), R1.2, R2.1
/MOTOR_N: D1.2 (A), M1.2 (-), Q1.3 (D)
/SOS_BTN: SW1.1, U1.10 (D9/MISO)
/TFT_BLK: U1.4 (D3), U5.8 (BLK)
/TFT_CS: U1.8 (D7/RX), U5.2 (CS)
/TFT_DC: U1.7 (D6/TX), U5.3 (DC)
/TFT_MOSI: U1.11 (D10/MOSI), U5.4 (SDA)
/TFT_SCK: U1.9 (D8/SCK), U5.5 (SCL)
/VCHG: D4.1 (A1), D5.2 (A), J2.1
GND: C1.2, C2.2, C3.2, D4.2 (A2), J2.2, Q1.2 (S), R2.2, R3.2, SW1.2, U1.13 (GND), U2.4 (GND), U2.5 (GND), U3.2 (GND), U3.6 (A0), U3.7 (A1), U3.8 (A2), U4.4 (GND), U5.6 (GND)

Notes on the sheet:
A. Vi điều khiển XIAO nRF52840 Sense (hàn thẳng lên mạch)
Gán chân: D0=ECG_OUT, D1=ECG_LOD (LO+ hoặc LO-), D2=motor, D3=đèn nền TFT (pad 8), D4/D5=I2C (MAX30102 0x57, MAX30205 0x48), D6=TFT_DC, D7=TFT_CS, D8=TFT_SCK, D9=nút SOS (INPUT_PULLUP), D10=TFT_MOSI. I2C không thêm điện trở kéo lên: hai module đã có sẵn. Pin LiPo 502030 hàn thẳng 2 dây vào pad BAT+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
B. Nguồn: sạc pogo 5 V (pin nối thẳng vào XIAO)
Chân sạc pogo -> TVS SMAJ5.0A về GND -> SS14 nối tiếp -> chân 5V của XIAO. SS14 chặn dòng ngược từ USB-C ra chân pogo khi cắm cả hai. Mạch sạc LiPo nằm sẵn trên XIAO (BQ25101). Pin 502030 (5 x 20 x 30 mm, có PCM): 2 dây đỏ/đen hàn thẳng vào pad BAT+ / BAT- ở mặt dưới XIAO, luồn ra cạnh thân XIAO. B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
C. PPG: module MAX30102 (mặt da)
Module đen 2x4: VIN SDA SCL GND / GND RD IRD INT (đã đo 27/10/2026). INT, IRD, RD bỏ trống. Module có LDO 1,8 V, tụ và điện trở kéo lên riêng.
D. Nhiệt độ da: module CJMCU-30205 (mặt da)
VCC chỉ cấp 3,3 V (không bao giờ 5 V). A0=A1=A2=GND -> địa chỉ 0x48. OS bỏ trống. Đặt cách đèn LED MAX30102 tối thiểu 10 mm.
E. ECG: module AD8232 (cắm thẳng) và điện cực
LO+ và LO- gộp bằng 2 diode (OR) vào D1, R3 kéo xuống: D1 = 1 khi tuột điện cực. Module cắm thẳng qua 9 lỗ (tháo giắc 3,5 mm). RA/LA/RL nối điện cực bằng đường mạch. SDN bỏ trống (module tự kéo lên, AD8232 luôn chạy). Module có tụ riêng.
F. Màn hình tròn GC9A01 1,28" (hàn thẳng)
RST nối thẳng 3V3 (bỏ R4, C9): màn tự reset khi cấp nguồn, firmware RST = -1. Pad 8 (BLK -> D3) chỉ dùng khi module có 8 chân; module 7 chân bỏ trống pad 8. THỨ TỰ CHÂN CẦN KIỂM TRA TRÊN MODULE THẬT.
G. Motor rung 1027 (nguồn 3V3) và nút SOS
Motor lấy nguồn 3V3 (không lấy VBAT). C3 10 uF đặt sát motor. Q1 đóng cắt phía thấp, R2 giữ motor tắt khi XIAO khởi động. Nút SOS nối D9 xuống GND, firmware bật INPUT_PULLUP.
H. Cơ khí (không lỗ vít)
Bản 2.0 không còn chỗ cho 4 lỗ M2. Mạch kẹp trong vỏ bằng gờ/rãnh ở mép, giữ thêm bằng keo nóng hoặc băng keo 2 mặt. Pin 502030: vùng 20 x 30 mm mặt trên. Motor 1027: dán mặt dưới (mặt da).

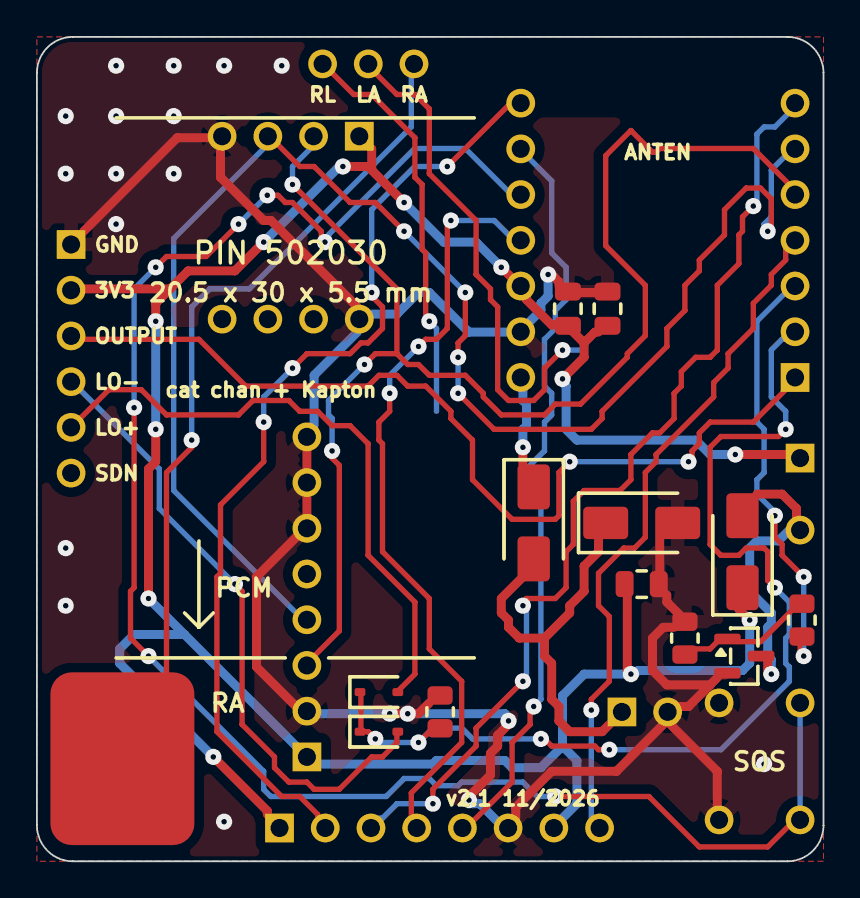
[picture p18: board dong_ho_module_v2.kicad_pcb from above]

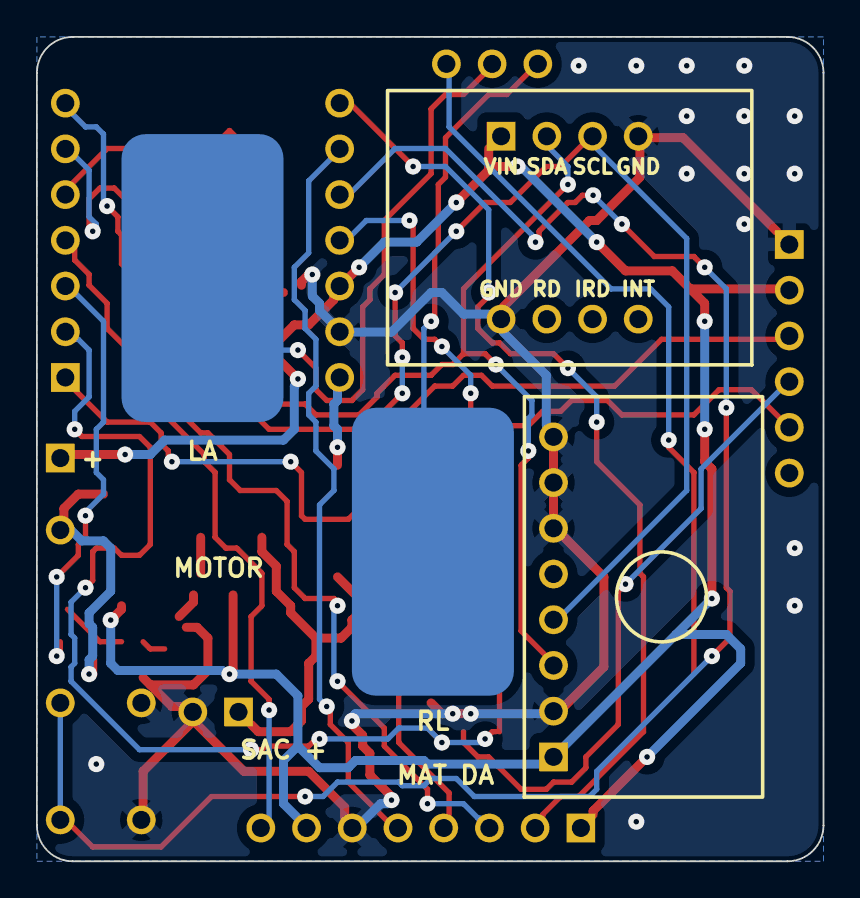
[picture p19: board dong_ho_module_v2.kicad_pcb from below]

Board: 2 copper layers, 43.7 x 45.8 mm, 23 parts (6 on the bottom side), 22 nets.
