Doantheodoisuckhoe/Thietbitheodoisuckhoe/(commit log)

2026-10-05 Khởi tạo cấu trúc dự án: README, .gitignore, thư mục firmware/algorithm/app/server/hardware
    Claude-Session: https://claude.ai/code/session_01M2HBKoKCuSW8eLAAm2Nsje
2026-10-05 Thêm .gitattributes chuẩn hóa xuống dòng và hướng dẫn dùng Git trên máy
    Claude-Session: https://claude.ai/code/session_01EBsmfAmoFDCNzjXhNNCMmD
2026-10-05 firmware: sketch kiểm tra thư viện cảm biến và ghi chú môi trường đã kiểm chứng
    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
2026-10-05 docs: danh sách mua linh kiện và máy đo đối chứng đợt 1
    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
    [Danh_sach_mua_linh_kien_dot_1.xlsx]
2026-10-05 docs: nhật ký tuần 1, cập nhật README (phiên bản, tài liệu, công cụ nhóm)
    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
2026-10-11 firmware: đọc MAX30102, lấy mẫu AD8232 bằng timer, gửi nhịp tim qua BLE
    Ba sketch mới cho XIAO nRF52840 Sense, viết sẵn trong lúc chờ linh kiện:
    - doc_max30102: 100 mẫu/giây, in CSV t_ms,red,ir
    - doc_ad8232: 250 mẫu/giây bằng TIMER4, in CSV t_ms,ecg,tuot_dien_cuc
    - ble_nhip_tim: nhịp tim từ MAX30102 qua BLE Heart Rate Service
    Cả ba biên dịch được với gói Seeed nRF52 Boards 1.1.13, chưa chạy trên board.
    Claude-Session: https://claude.ai/code/session_01SKv2s5udJosCJofUt2jVFQ
2026-10-15 hardware: sơ đồ nguyên lý KiCad mạch đồng hồ 40x40 mm (bản 0.1)
    - MAX30101, AD8232 (cấu hình 0,5-40 Hz theo datasheet), TMP117, LDO 1,8 V
    ME6211C18, diode ESD cho điện cực ECG, TVS chân sạc pogo, XIAO hàn phẳng
    - Gán chân XIAO giữ như firmware hiện có; D2 điều khiển motor, D9 nút SOS
    - Mỗi linh kiện có trường LCSC; xuất sẵn BOM JLCPCB và bản PDF
    - ERC sạch trên KiCad 10.0.7
    [bom_jlcpcb.csv, dong_ho_suc_khoe.kicad_sch]
2026-10-17 firmware: sketch kiểm tra phần cứng có sẵn trên XIAO nRF52840 Sense
    Kiểm tra USB Serial, LED RGB, IMU LSM6DS3, micro PDM, điện áp pin và quảng bá BLE (tên DATN-XIAO-TEST).
2026-10-17 firmware, algorithm: ghi dữ liệu IMU và thuật toán ngưỡng phát hiện té ngã
    Claude-Session: https://claude.ai/code/session_01UG8MhwybpxAzQQjufe5eYM
2026-10-17 te_nga: giữ đúng 100 mẫu/giây và sửa thuật toán theo lần ngã thật đầu tiên
    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
2026-10-17 data: du lieu IMU te nga ngay 17/10
    [NGA_20261017_224755.csv, di_bo_20261017_222959.csv, di_bo_20261017_223059.csv, nga_20261017_223131.csv, nga_20261017_224437.csv, nga_20261017_224513.csv, nga_20261017_224541.csv, nga_20261017_224605.csv]
2026-10-21 hardware: mạch ghép module 2 lớp 50x62 mm (sơ đồ, PCB, Gerber)
    - hardware/pcb_module/: XIAO nRF52840 Sense cắm header, module MAX30102,
    CJMCU-30205, AD8232 (nối dây), màn GC9A01 (nối dây), motor, SOS, sạc pogo.
    - LO+/LO- gộp qua 2 diode 1N4148W vào D1; D3 chuyển sang đèn nền TFT.
    - PCB 2 lớp đã đi dây và đổ GND hai mặt; ERC 0, DRC 0, khớp sơ đồ.
    - Xuất PDF sơ đồ, BOM, Gerber + khoan (zip), ảnh 3D.
    - Bản chip rời 40x40 mm trong hardware/pcb/ ghi chú lưu trữ (hướng phát triển).
    [bom.csv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]
2026-10-21 firmware: sketch test breadboard theo chân mạch in module
    Thêm firmware/test_breadboard: một sketch test cùng lúc MAX30102, MAX30205,
    AD8232, IMU và nút SOS, kèm hướng dẫn cắm dây và sơ đồ PNG. Cập nhật bảng
    chân trong firmware/README.md theo phương án cuối.
    Claude-Session: https://claude.ai/code/session_016xjgaR8Q12uTCt4QMw8J44
2026-10-21 firmware: sketch kiểm tra chập chân XIAO sau khi hàn header
    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
2026-10-21 kiem_tra_chan: hướng dẫn thử mối hàn hở bằng dây nối
    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
2026-10-21 Them firmware BLE gui so do va canh bao cho app (phuong an 1)
    - firmware/ble_suc_khoe: nhip tim, SpO2, nhiet do, pin moi giay; canh bao SOS,
    te nga (huy trong 15 giay), chi so bat thuong; app xac nhan qua dac tinh Lenh
    - docs/giao-thuc-ble.md: UUID, tung byte, viec app phai lam khi co canh bao
    - app/thu_ble_tren_may_tinh.py: thu dong ho bang may tinh (bleak)
    Claude-Session: https://claude.ai/code/session_019EsP4J9aSQueRN9dsEXRux
2026-10-24 kiem_tra_chan: sửa ví dụ mối hàn hở cho đúng thực tế
    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
2026-10-24 ble_suc_khoe: đếm nhịp tim bằng tự tương quan, chịu được nền trôi
    Đo thử 24/10: nền IR trôi lớn hơn nhịp tim nên cách tìm đỉnh cũ không
    bắt được nhịp nào (HR luôn bằng 0). Thay bằng lọc 0,5-5 Hz, đạo hàm và
    tự tương quan trong cửa sổ 6 giây. Thêm algorithm/nhip_tim/thu_nhip_tim.py
    (bản Python giống firmware, thử bằng sóng giả hoặc CSV của doc_max30102).
    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
2026-10-27 PCB 1.1: MAX30102 module 2x4 (đo thật), diode SOD-323 và TVS SMA
    Footprint mới cho module MAX30102 đen 2x4 chân (20x15 mm, hai hàng cách 10,16 mm),
    D2/D3 đổi sang 1N4148WS SOD-323, D4 sang SMAJ5.0A SMA. Cần chạy lại script trên máy
    có KiCad 10 để dựng lại sơ đồ và PCB.
    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
2026-10-27 PCB module 1.1: dựng lại bằng KiCad 10 với MAX30102 2x4
    - Chạy lại gen_fp/gen_sch/gen_pcb trên KiCad 10.0.7, thêm footprint Module_MAX30102_2x4.
    - U2 đổi góc 180 -> 0 (vẫn lật mặt dưới) để chân khớp module thật:
    VIN (28,81; 24,92) ... INT (21,19; 35,08).
    - D4 (TVS SMA) dời xuống y 35,4 để courtyard không chồng D5.
    - Chữ chân U2 trên lụa 0,6/0,1 mm cho đúng quy tắc lụa.
    - ERC 0 lỗi 0 cảnh báo; DRC 0 vi phạm, 0 chưa nối, khớp sơ đồ 0 lỗi.
    - Xuất lại PDF, BOM, gerber + khoan, zip và ảnh 3D hai mặt.
    Claude-Session: https://claude.ai/code/session_016xjgaR8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
    [bom.csv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]
2026-10-28 PCB 1.2: script áp tiêu chuẩn xưởng (mũi khoan, pad = lỗ + 0,6, via 0,3/0,9, phủ đồng 0,65 mm, lụa 0,2 mm)
    Claude-Session: https://claude.ai/code/session_01DtVKYLjz9b4xdEphcSQTzb
2026-10-28 PCB 1.2: áp tiêu chuẩn xưởng, DRC 0 lỗi, xuất lại Gerber
    - Chạy cong_cu/ap_quy_tac_xuong.py trên KiCad 10.0.7: 58 pad xuyên lỗ, 101 via,
    2 vùng phủ GND, 50 chữ lụa, 106 nét lụa.
    - Lỗ khoan PTH chỉ còn 0,3 (via), 0,8 (JST) và 1,0 mm (header), pad = lỗ + 0,6 mm;
    via 0,3 / 0,9 mm trên cả F.Cu và B.Cu; phủ đồng GND cách 0,65 mm, thermal 0,5 mm.
    Lỗ bắt vít H1-H4 giữ 2,2 mm không mạ.
    - Sửa script: làm tròn khi đổi mm (0,3 + 0,6 bị cắt còn 0,899999 mm làm DRC báo
    202 lỗi via) và đặt cỡ via theo từng lớp (API KiCad 10, hết hộp Debug Alert).
    - Dời chữ lụa "RA" cạnh J6 sang trái 0,6 mm cho khỏi ch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
    [dong_ho_module-B_Cu.gbl, dong_ho_module-B_Mask.gbs, dong_ho_module-B_Paste.gbp, dong_ho_module-B_Silkscreen.gbo, dong_ho_module-Edge_Cuts.gm1, dong_ho_module-F_Cu.gtl, dong_ho_module-F_Mask.gts, dong_ho_module-F_Paste.gtp]
2026-10-28 Firmware: màn tròn GC9A01 cho ble_suc_khoe (chỉ số, té ngã, SOS, cảnh báo) + ảnh mô phỏng
    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
2026-10-28 man_hinh.h: bộ đệm nhiệt độ 12 byte (bỏ cảnh báo snprintf)
    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
2026-10-28 ECG 30 giay: dong ho gui song qua BLE, app do va tinh nhip tim
    - firmware/ble_suc_khoe: lenh 03/04, lay mau AD8232 250 Hz (TIMER4), gui goi qua dac tinh ECG 0005
    - app: man hinh ECG (huong dan, song chay, ket qua nhip tim, 6 dai song tren giay ECG, luu 10 lan do)
    - app/lib/ecg.dart + algorithm/ecg/phan_tich_ecg.py: loc 50 Hz, bo troi nen, Pan-Tompkins rut gon
    - test/ecg_test.dart: doc goi, nhip tim song gia 45-150 l/p, mat goi, luu/doc ban ghi
    - docs/giao-thuc-ble.md: dinh dang goi ECG
    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
2026-10-30 PCB 1.3: vùng pin 45 mm, chuyển D1/Q1/R1/R2 xuống mặt dưới
    - Pin thật đo được 45 x 30 x 5,5 mm (tính cả mạch bảo vệ), dài hơn vùng 40 mm của bản 1.2.
    Vùng pin mặt trên nới tới mép phải (x 5-50 mm); khung pin trên User.Comments/F.Fab và
    chữ lụa đổi thành 45 x 30 x 5.5 mm (PCM ->), nhãn v1.3.
    - D1 (SS14), Q1 (AO3400A), R1, R2 chuyển xuống mặt dưới, vào khoảng trống dưới điện cực E1,
    cạnh J1 (cách E1 >= 1 mm). Mặt trên vùng x 145-150 không còn linh kiện dán, chỉ còn pad J1.
    - Đi lại dây motor: MOTOR_N, MOTOR_G nối ở mặt dưới; VBAT+ từ XIAO xuống J1 ở mặt trên;
    MOTOR_EN qua 1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
    [dong_ho_module-B_Cu.gbl, dong_ho_module-B_Mask.gbs, dong_ho_module-B_Paste.gbp, dong_ho_module-B_Silkscreen.gbo, dong_ho_module-Edge_Cuts.gm1, dong_ho_module-F_Cu.gtl, dong_ho_module-F_Mask.gts, dong_ho_module-F_Paste.gtp]
2026-10-30 PCB 1.3: đầu PCM của pin quay sang trái (chỉ đổi lụa)
    - Chữ lụa F.Silkscreen "(PCM →)" đổi thành "(← PCM)": mạch bảo vệ của pin nằm ở mép trái,
    sát J3 (dây pin chỉ cần ~5 mm), không đè lên mối hàn J1 (VBAT+/MOTOR_N) ở mép phải.
    - Không đổi đồng, lỗ khoan hay mask; F_Cu, B_Cu và file khoan chỉ khác ngày tạo.
    - README: đặt pin đầu PCM về mép trái; cắt sát chân U2 và J1 ở mặt trên, dán Kapton,
    lót mút ~1 mm dưới pin.
    - DRC 0 lỗi, 0 chưa nối, khớp sơ đồ 0 lỗi; còn 6 cảnh báo lib_footprint_mismatch J1-J6.
    - Xuất lại gerber/, gerber_dong_ho_module.zip và pcb_mat_tren.png.
    C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
    [dong_ho_module-B_Cu.gbl, dong_ho_module-B_Mask.gbs, dong_ho_module-B_Paste.gbp, dong_ho_module-B_Silkscreen.gbo, dong_ho_module-Edge_Cuts.gm1, dong_ho_module-F_Cu.gtl, dong_ho_module-F_Mask.gts, dong_ho_module-F_Paste.gtp]
2026-10-30 Xem gio tren dong ho: app gui gio khi ket noi, man chinh hien HH:MM
    - Lenh BLE moi 05 + uint32 (giay tu 1/1/2000, gio dia phuong); app gui moi lan ket noi
    - Firmware dem gio bang millis(), man chinh hien gio tren cung, chua co gio thi --:--
    - Hang Bluetooth + pin chuyen xuong duoi gio
    - Cap nhat docs/giao-thuc-ble.md, README, chu thich chan theo mach 1.3
    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
2026-10-30 Xem giờ: biên dịch 30/10, vẽ lại ảnh xem trước màn hình
    - Biên dịch ble_suc_khoe cho Seeed XIAO nRF52840 Sense (core 1.1.13): 0 lỗi,
    Flash 173704 byte (21 %), RAM 24380 byte (10 %).
    - man_hinh.h: bộ đệm giờ 6 -> 12 byte để hết cảnh báo snprintf (như bộ đệm nhiệt độ).
    - Vẽ lại 8 ảnh xem trước và ảnh tổng hợp bằng đúng man_hinh.h: giờ 09:41 / --:-- ở trên cùng
    không đè lên hàng Bluetooth + pin và số nhịp tim.
    - firmware/README.md: ghi kết quả biên dịch 30/10.
    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
2026-10-30 ECG xem từ xa: app tải mỗi lần đo lên Firebase, web thêm mục điện tâm đồ
    - App: sau mỗi lần đo ECG 30 giây, tải sóng (ecgSong/{luc}) rồi tóm tắt (ecg/{luc}) lên Firebase;
    mất mạng thì giữ tối đa 5 lần đo và gửi lại. Thêm 1 test.
    - Web: mục "Điện tâm đồ (ECG)" liệt kê 20 lần đo gần nhất, vẽ 6 dải 5 giây trên nền giấy ECG
    có chấm đỉnh R, nút tải CSV cho bác sĩ; dữ liệu mẫu ở chế độ demo. Thêm src/ecg.js và test.
    - Luật Firebase: thêm index cho ecg. Cập nhật README app và web.
    Claude-Session: https://claude.ai/code/sess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
2026-11-01 Nhịp tim: đọc thẳng FIFO MAX30102, không mất mẫu khi vòng lặp chậm
    Bộ đệm của thư viện SparkFun chỉ giữ 4 mẫu (40 ms). Khi firmware có màn hình,
    BLE và đọc nhiệt độ, vòng loop() lâu hơn 40 ms nên mất mẫu, sóng mạch đứt khúc:
    SpO2 vẫn ra số nhưng nhịp tim luôn bằng 0. Giờ firmware đọc thẳng FIFO 32 mẫu
    (320 ms) của cảm biến và in thêm PPG=.../s (đúng là khoảng 100) để kiểm tra.
    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
2026-11-01 doc_max30102: I2C 100 kHz như firmware chính
    Ở 400 kHz, MAX30102 chỉ có điện trở kéo lên bên trong XIAO nên không trả lời,
    sketch đứng im sau dòng báo lỗi và Serial Monitor trống.
    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
2026-11-01 I2C: giải phóng bus khi SDA bị treo lúc khởi động (ble_suc_khoe, doc_max30102)
    - Đo thật trên máy MINH 01/11: sau khi nạp code, SDA=0 SCL=1, mọi lệnh I2C treo
    nên Serial không in gì (cả doc_max30102 lẫn sketch thử). Cảm biến bị reset giữa
    chừng lúc đang đọc và giữ SDA ở mức thấp.
    - Thêm giaiPhongI2C(): nếu SDA thấp thì phát tối đa 9 xung SCL rồi mới Wire.begin.
    Thử thật: 9 xung xong SDA=1, quét I2C thấy 0x48 (MAX30205) và 0x57 (MAX30102),
    doc_max30102 in đủ ~100 dòng/giây.
    - Biên dịch: ble_suc_khoe 173824 byte (21 %), doc_max30102 47332 byte (5 %).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
    [ble_suc_khoe.ino, doc_max30102.ino]
2026-11-01 Nhịp tim: sửa lỗi HR luôn = 0 (so thời gian bị tràn số)
    - Trong loop(), bayGio = millis() lấy TRƯỚC docFifoPpg(). Khi có nhịp mới, docFifoPpg()
    đặt lanCoNhipCuoi = millis() (muộn hơn bayGio vài ms), nên "bayGio - lanCoNhipCuoi"
    (uint32) tràn thành số rất lớn > 5000 và xóa ngay nhipTim, soNhip vừa tính. HR luôn 0,
    trong khi SpO2 vẫn ra số.
    - Sửa: so với millis() hiện tại.
    - Chẩn đoán trên máy MINH 01/11 bằng bản in lý do mỗi giây: thuật toán trả nhịp hợp lệ
    (tự tương quan 0,81-0,93) nhưng HR vẫn 0. Sau khi sửa, đo ngón tay: HR hiện sau ~9 giây,
    82-90 lần/phút, SpO2 93-97 %.
    Co-Author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
2026-11-03 Thêm file tóm tắt toàn bộ đồ án (03/11/2026)
    Claude-Session: https://claude.ai/code/session_01UXjQbvfw8hPgXLiM6wQvHw
2026-11-12 Mạch v2.0 không dây nối: 42,2 x 45,8 mm, module hàn/cắm thẳng
    Thư mục mới hardware/pcb_module_v2 (bản 1.3 trong pcb_module giữ nguyên).
    - XIAO hàn thẳng, pin 502030 nối thẳng BAT+/BAT- của XIAO (bỏ J3, J4, VBAT)
    - AD8232 cắm thẳng qua 9 lỗ đúng toạ độ đo; màn GC9A01 hàn thẳng 7 pad + pad 8 BLK
    - RA thành pad đồng lộ mặt trên; motor lấy 3V3 + C3; nút SOS góc vuông ở mép
    - Script kiem_tra_kich_thuoc.py kiểm khoảng cách pad module và chồng tầng
    - ERC 0, DRC --schematic-parity 0 lỗi 0 cảnh báo; xuất gerber, BOM, PDF, ảnh
    [bom.csv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]
2026-11-12 Mạch v2.1: sửa sau soát chéo (43,7 x 45,8 mm)
    - Bảng rộng thêm 1,5 mm: pin (20,5 mm thật) cách thân XIAO 1 mm
    - D5/D4/D1 dời khỏi vùng 3 mm dưới đầu cắm USB-C
    - Vùng cấm anten sâu 4,6 mm (XIAO lùi 0,6 mm), E1 ra ngoài vùng cấm
    - Mặt dưới chỗ dán motor không còn dây/via, E2 cách motor >= 1 mm
    - Nét lụa 0,2 mm, chữ nhỏ không dấu; BOM gộp mô tả D1/D5, thêm bom_ngoai_mach.csv
    - README: thứ tự lắp ráp, ENIG ghi trong đơn, NPTH rỗng, anten bị che, chiều cao chân màn
    - Script kiểm tra thêm các điều kiện trên; firmware: chú thích RST màn nối 3V3 ở mạch 2.x
    - ERC 0, DRC --schematic-parity 0 lỗi 0 c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
    [bom.csv, bom_ngoai_mach.csv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]
2026-11-12 Tiet kiem pin: thoi gian sang man cai tu app, CPU ngu, bao ve pin yeu, tat han tu app
    - Lenh BLE 06 ss: thoi gian sang man khi bam nhanh nut (3-120 giay), app gui moi lan ket noi
    - Lenh BLE 07 AA: tat han (System OFF), giu nut SOS 2 giay hoac cam sac de bat lai
    - Pin < 3,5 V: rung 3 lan + bit4 pin yeu; < 3,4 V khong cam USB: tat han
    - loop() ngu bang delay() den lan doc IMU ke tiep (tru luc do ECG)
    - App: chon thoi gian sang man, nut tat hang dong ho, hien pin yeu
    Claude-Session: https://claude.ai/code/session_01UXjQbw1MvuzdhSSzEtBRoG
