Doantheodoisuckhoe/Thietbitheodoisuckhoe/(notices)

Notices in the files:
parts and their libraries:
Seeed Studio XIAO nRF52840 Sense, hàn phẳng (castellated). Symbol/footprint từ Seeed OPL_Kicad_Library (CC-BY-SA-4.0)
